AlfonsoUSM/3LFCC_Testboard/testplan/TestPLan_3LFCC.xlsx

Sheet: Tests
 | Test number | Test description | Measurement details | Operating conditions | Equipment/ connection | Reference simulation | more tests?
 | T.01 | Transient output load voltage |  | IL = 0 to Imax/ Fsw = Fmin/ Temp = 25°C/ Nominal switching scheme | Use oscilloscope at filtered output to track and record voltage vs time | TBD | Efficiency
 | T.02 | Transient output load current |  | IL = 0 to Imax/ Fsw = Fmin/ Temp = 25°C/ Nominal switching scheme | Ammeter (sourcemeter?) to record current vs time | TBD | Load regulation?
 | T.03 | Transient input load voltage |  | IL = 0 to Imax/ Fsw = Fmin/ Temp = 25°C/ Nominal switching scheme | Use oscilloscope at filtered output to track and record voltage vs time | TBD | Line regulation?
 | T.04 | Transient input load current |  | IL = 0 to Imax/ Fsw = Fmin/ Temp = 25°C/ Nominal switching scheme | Ammeter (sourcemeter?) to record current vs time | TBD | Load transient response?
 | T.05 | Input/output delay |  | Nominal Imax/ Fsw = Fmin/ Temp = 25°C/ Nominal switching scheme | Oscilloscope at driving signal and output pre-filter voltage | TBD | noice robustness?
 | T.06 | Load voltage range |  | Nominal Imax/ Fsw = Fmin/ Temp = 25°C/ Min. Voltage switching scheme | Use oscilloscope at filtered output to track and record voltage vs time | TBD
 | T.07 | Load current step response |  | Nominal Imax/ Fsw = Fmin/ Temp = 25°C/ Nominal switching scheme | Use oscilloscope at filtered output to track and record voltage vs time | TBD
 | T.08 | Startup transient |  | Nominal Imax/ Fsw = Fmin/ Temp = 25°C/ Nominal switching scheme | Use oscilloscope at filtered output to track and record voltage vs time | TBD
 | T.09 | Switching frequency |  | Nominal Imax/ Fsw = 50MHz?/ Temp = 25°C/ Nominal switching scheme | Use oscilloscope at filtered output to track and record voltage vs time | TBD
 | code | chip (caso) | External Flying Capacitor | Min Switching frequency (Fmin) | op. mode | Max Load Current (Imax)
 | a | standalone | - | 50 MHz | single core output | 150mA
 | b |  |  |  | dual core output | 300mA
 | c |  |  |  | interleaved
 | d | bare die 1 | ? | 10 MHz | single core output | 150mA
 | e |  |  |  | dual core output | 300mA
 | f |  |  |  | interleaved
 | g |  | ? | 1 MHz | single core output | 150mA
 | h |  |  |  | dual core output | 300mA
 | i |  |  |  | interleaved
 | j | bare die 2 | ? | 1 MHz | single core output | 300mA
 | k |  |  |  | dual core output | 600mA
 | l |  |  |  | interleaved
 | Chips (cases) | Nominal Frequency | Max current / core
1 | Standalone Chip (packaged) | 50 MHz | 150 mA
2 | Bare die 1(External capacitor) | 1 MHz / 10 MHz | 150 mA
3 | Bare die 2(Extra bonding for increased current) | 1 MHz / 10 MHz | 300 mA
 | Chip boards
1 | efabless breackout board
2 | custom board for bare die (?)
 | Operation modes
1 | single core
2 | dual core
3 | interleaved
 | Evaluation boards
1 | open loop
2 | closed loop

Sheet: Specs
Spec name | Tests needed | Calculation
Rated power | T.01, T.02 | P_rated = AVG(VOUT)*AVG(IOUT)
Efficiency | T.01, T.02, T.03, T.04 | Efficiency = AVG(VOUT)*AVG(IOUT)/(AVNG(VIN)*AVG(IIN))
Ripple | T.01 | Ripple = MAX(VOUT) - MIN(VOUT)
Driver delay | T.05 | Tdelay = Trise_VOUT - Trise_VIN
Output voltage range | T.06 | Vrange = VOUT_MAX - VOUT_MIN
Startup time | T.08 | Tstartup = T(VOUT = VOUT_SPEC)
