AlfonsoUSM/3LFCC_Testboard/PCB_design/caravel_breakout_QFN.kicad_pcb

## KiCad design PCB_design/caravel_breakout_QFN.kicad_pcb (2023-02-20)

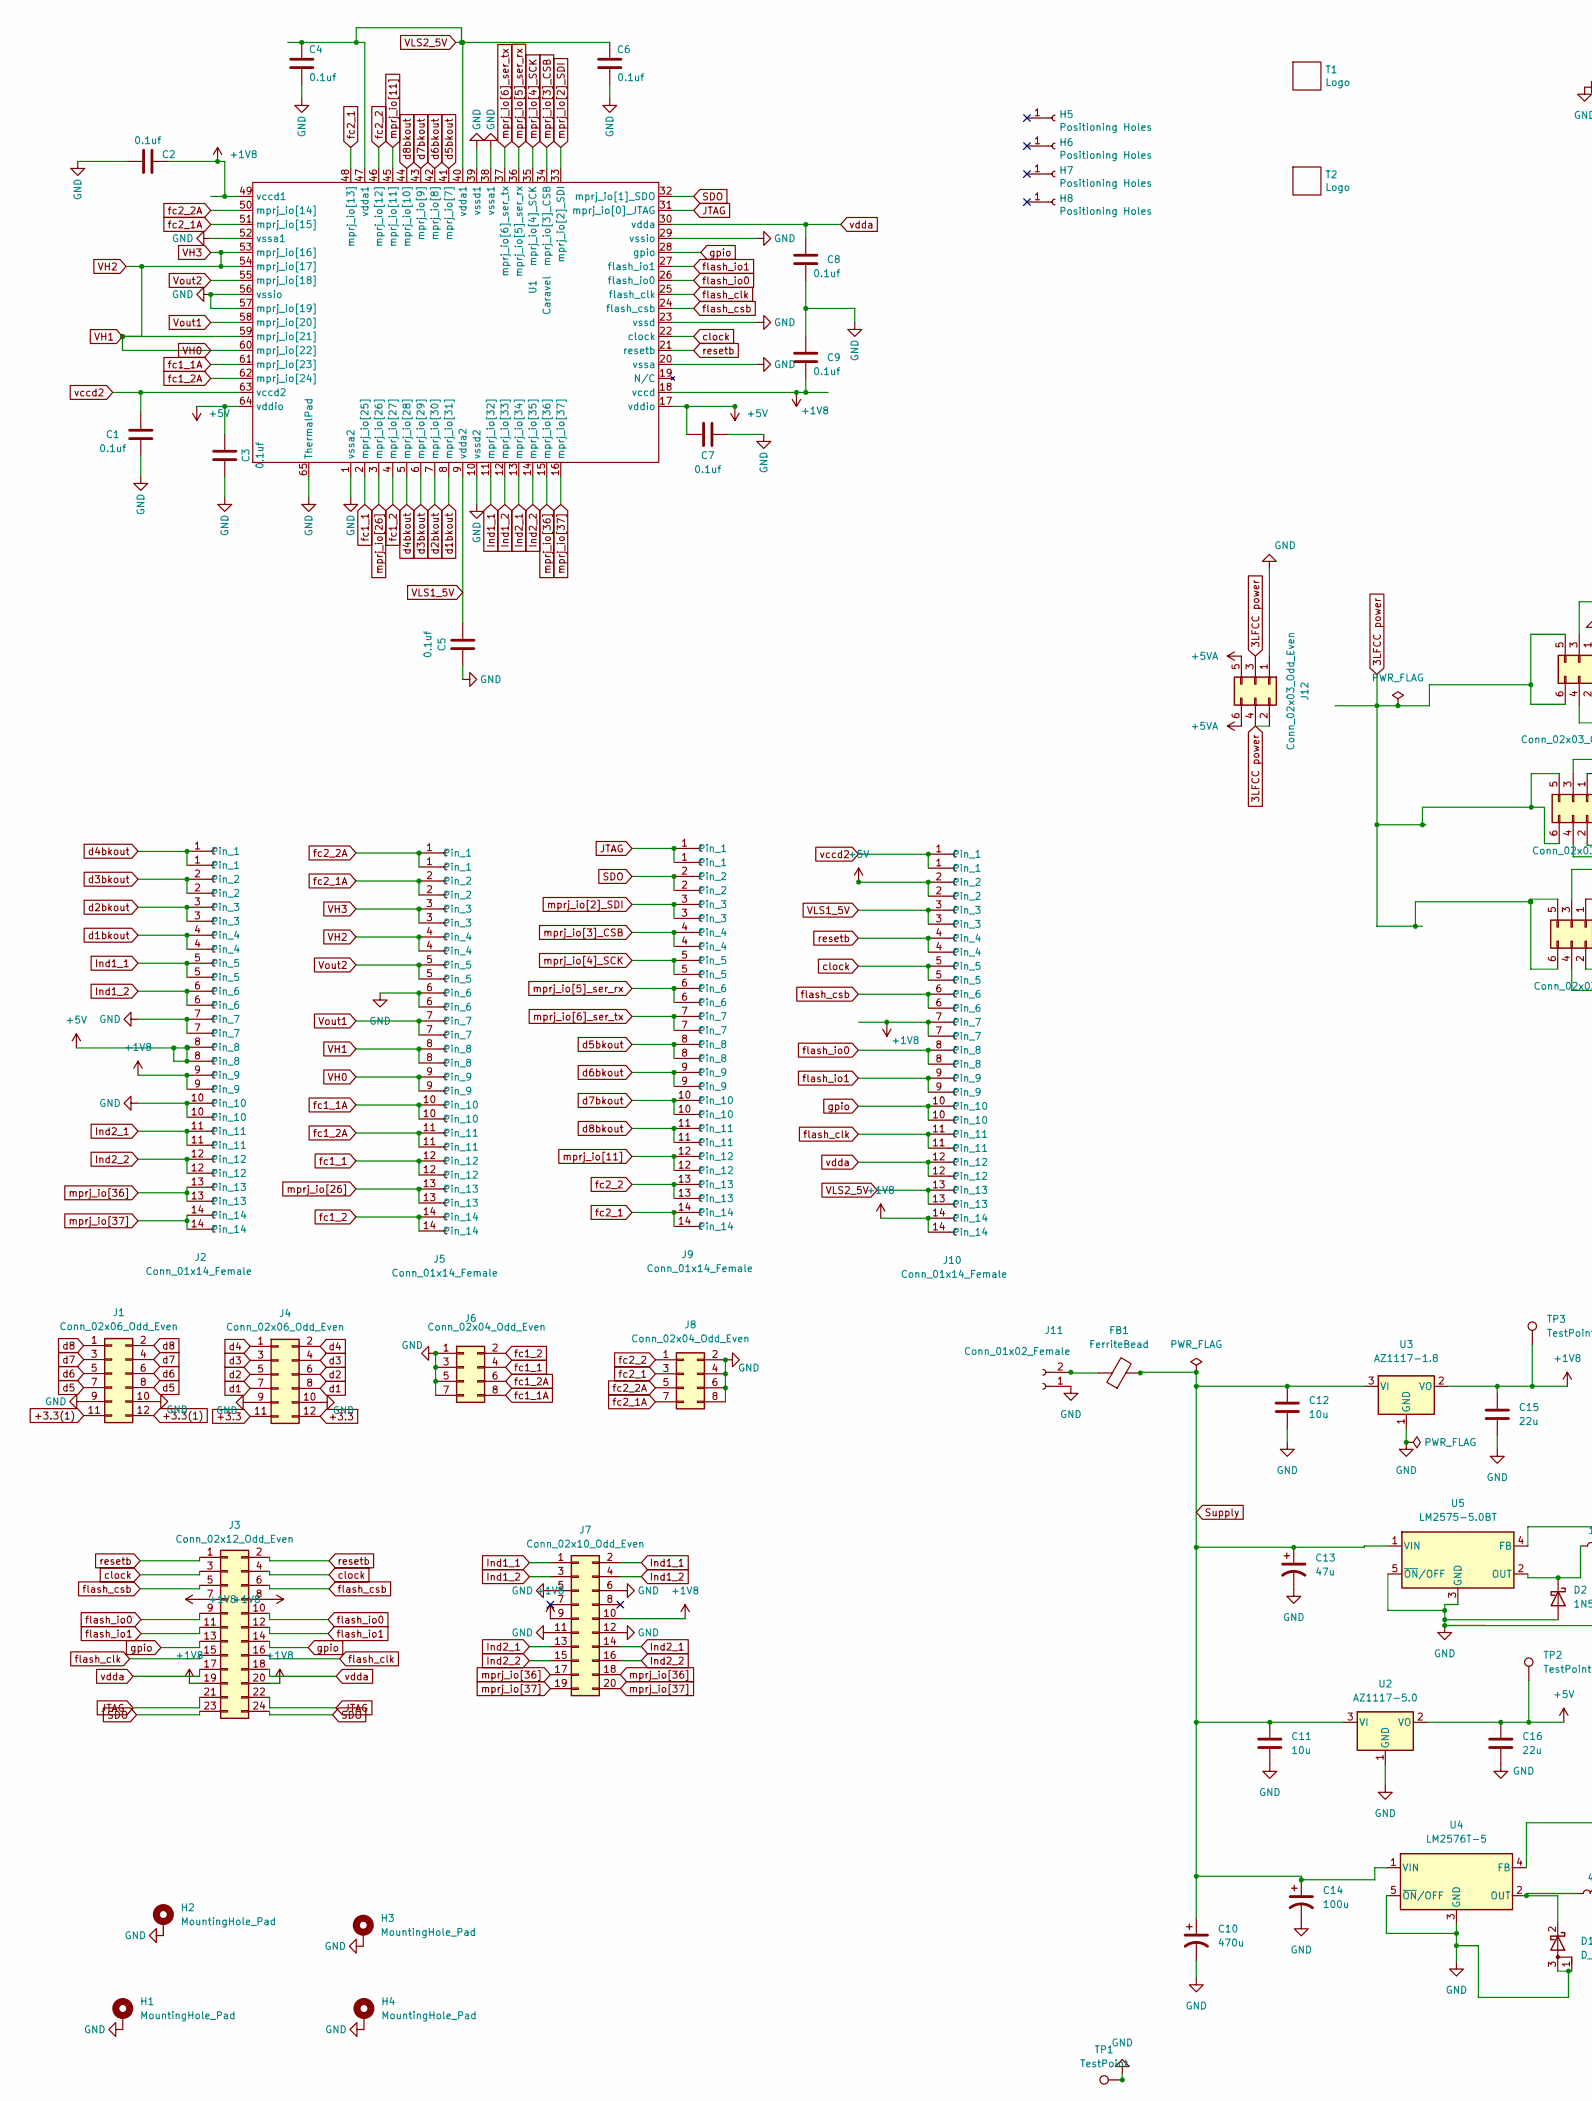
[picture p13: schematic caravel_breakout_QFN.kicad_sch, part in row 1, column 1]

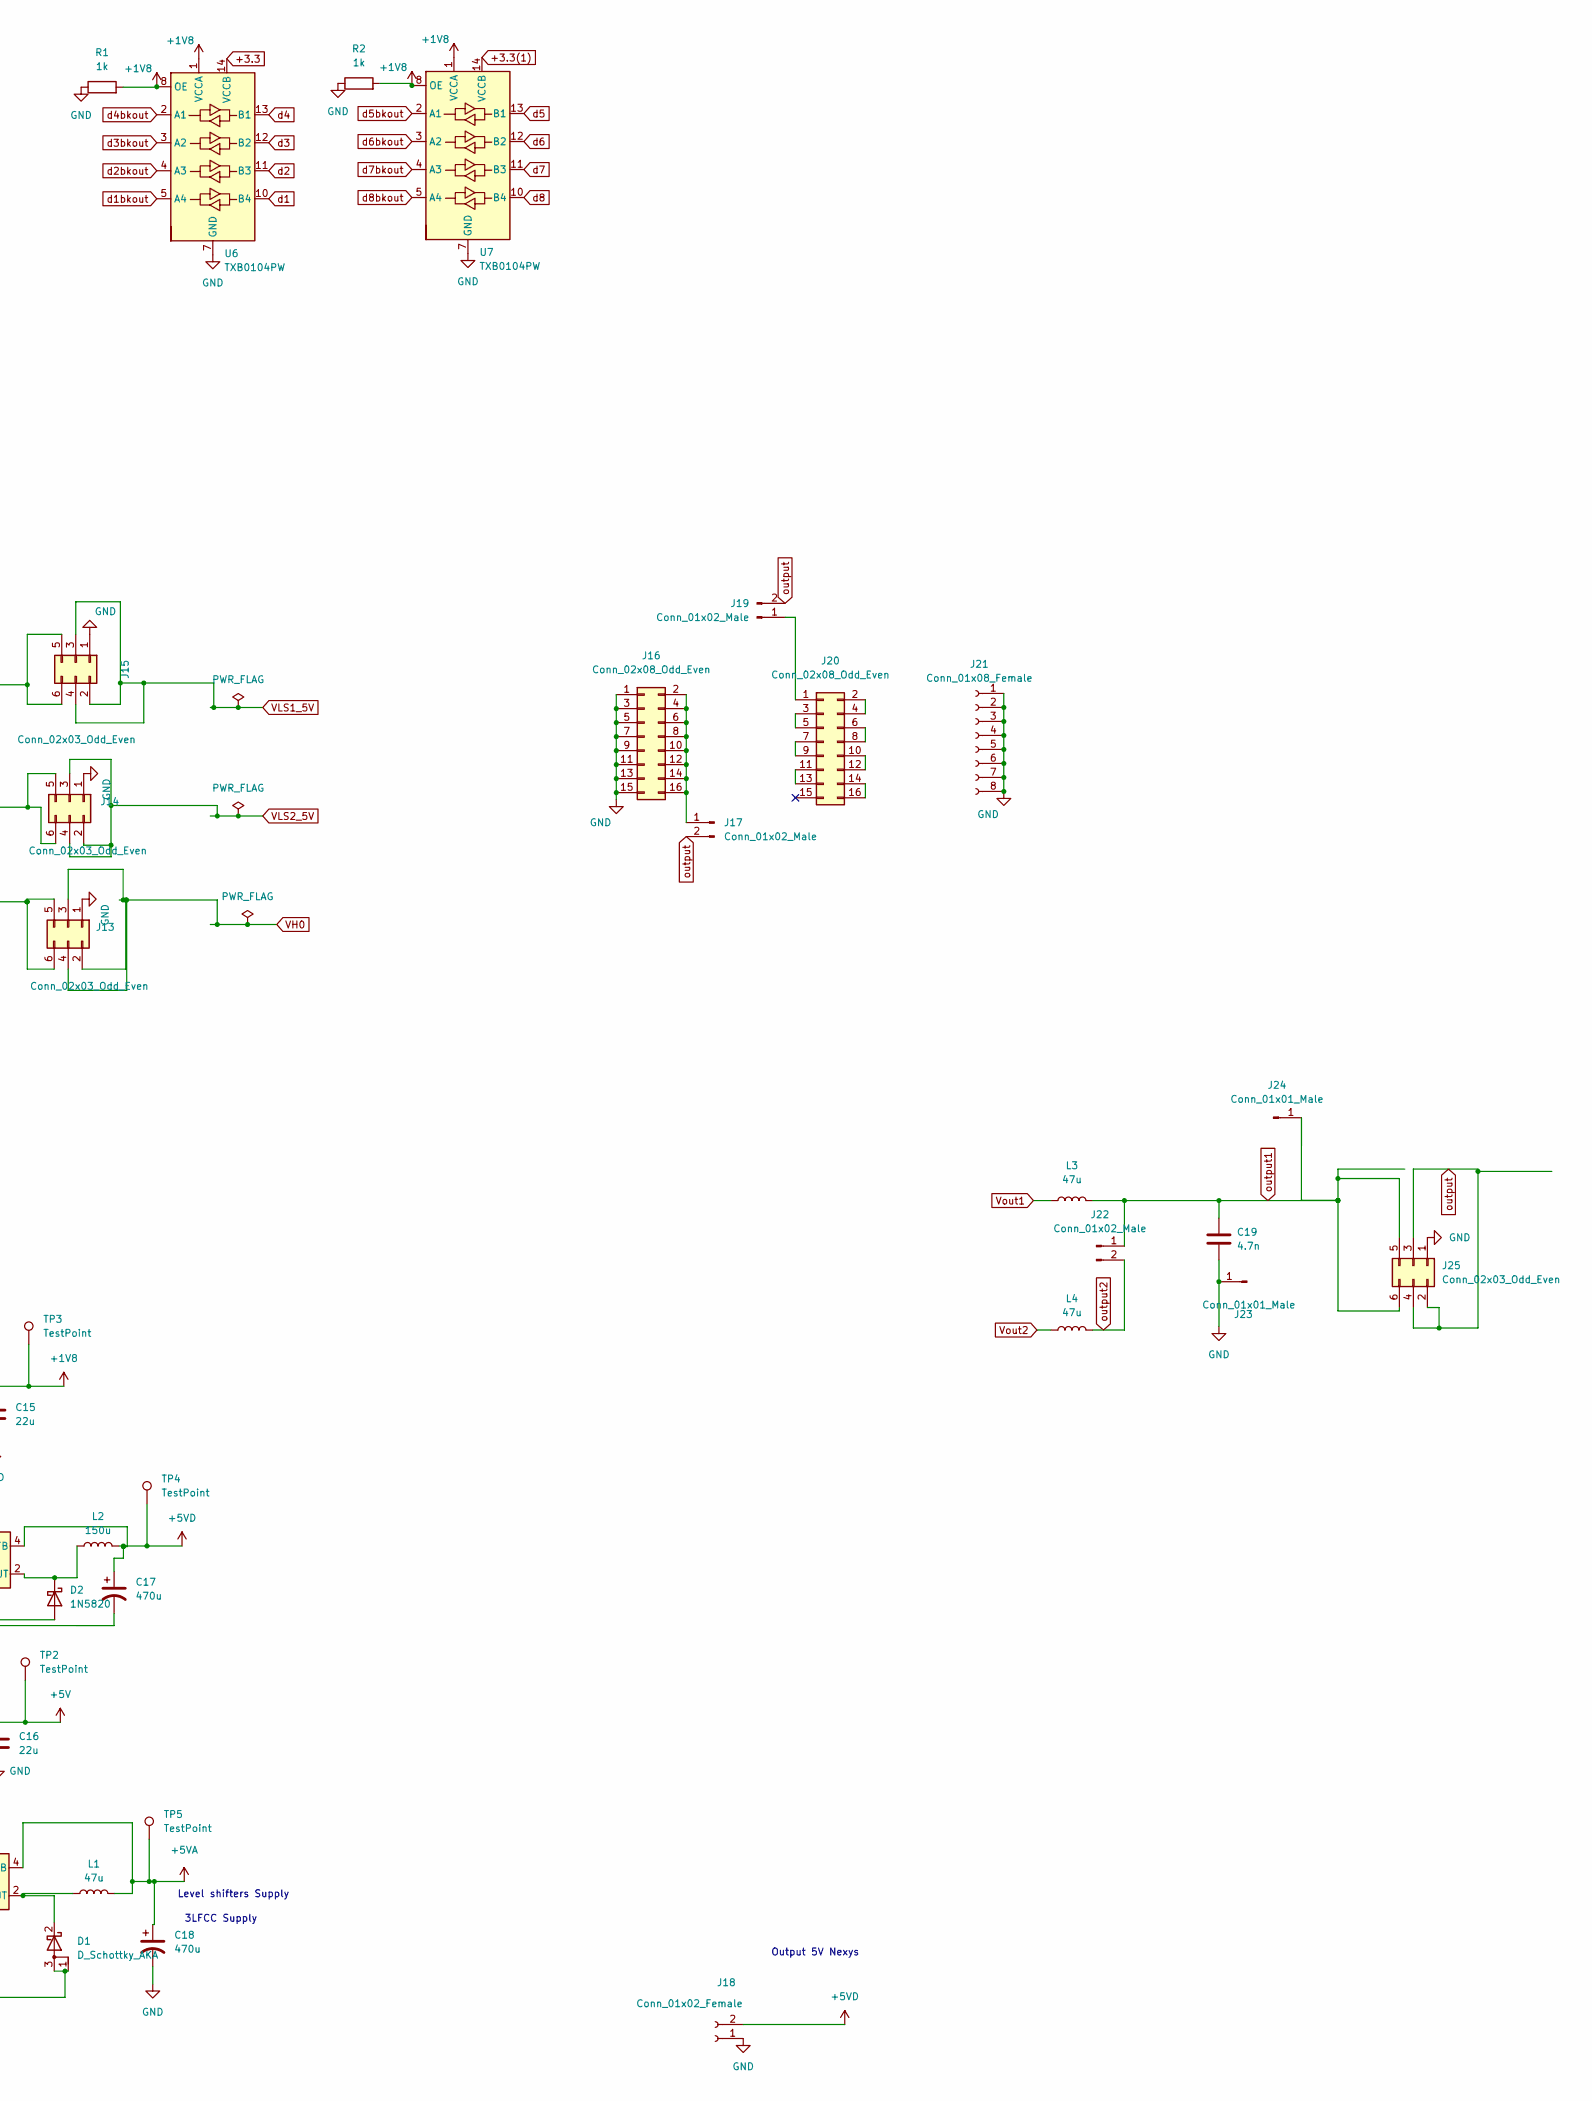
[picture p14: schematic caravel_breakout_QFN.kicad_sch, part in row 1, column 2]

Parts:
C1, C2, C3, C4, C5, C6, C7, C8, C9: 0.1uf; C_0402_1005Metric
C10: 470u; CP_Radial_D10.0mm_P5.00mm
C11, C12: 10u; C_1206_3216Metric
C13: 47u; CP_Radial_D5.0mm_P2.50mm
C14: 100u; C_Radial_D8.0mm_H11.5mm_P3.50mm
C15, C16: 22u; C_1206_3216Metric
C17, C18: 470u; CP_Radial_D10.0mm_P2.50mm
C19: 4.7n; C_1206_3216Metric
D1: D_Schottky_AKA; TO-252-2
D2: 1N5820; D_DO-201AD_P15.24mm_Horizontal
FB1: FerriteBead; L_1206_3216Metric
H1, H2, H3, H4: MountingHole_Pad; MountingHole_3.2mm_M3_Pad
H5, H6, H7, H8: Positioning Holes; MountingHole_2.2mm_M2_ISO7380_Pad
J1, J4: Conn_02x06_Odd_Even; PinSocket_2x06_P2.54mm_Vertical
J2, J5, J9, J10: Conn_01x14_Female; Caravel_Breakout_Connectors_2x14
J3: Conn_02x12_Odd_Even; IDC-Header_2x12_P2.54mm_Horizontal
J6, J8: Conn_02x04_Odd_Even; PinHeader_2x04_P2.54mm_Vertical
J7: Conn_02x10_Odd_Even; IDC-Header_2x10_P2.54mm_Horizontal
J11, J18: Conn_01x02_Female; TerminalBlock_bornier-2_P5.08mm
J12, J13, J14, J15: Conn_02x03_Odd_Even; PinHeader_2x03_P2.54mm_Vertical
J16, J20: Conn_02x08_Odd_Even; PinSocket_2x08_P2.54mm_Vertical
J17, J19, J22: Conn_01x02_Male; PinHeader_1x02_P2.54mm_Vertical
J21: Conn_01x08_Female; PinSocket_1x08_P2.54mm_Vertical
J23, J24: Conn_01x01_Male; PinHeader_1x01_P2.54mm_Vertical
J25: Conn_02x03_Odd_Even; PinHeader_2x03_P2.54mm_Horizontal
L1: 47u; L_Toroid_Vertical_L16.5mm_W11.4mm_P7.62mm_Pulse_KM-2
L2: 150u; L_Toroid_Vertical_L24.6mm_W15.5mm_P11.44mm_Pulse_KM-4
L3, L4: 47u; L_1210_3225Metric
R1, R2: 1k; R_0805_2012Metric
T1: Logo; logo_small
T2: Logo; ef_logo
TP1, TP2, TP3, TP4, TP5: TestPoint; TestPoint_Pad_D1.5mm
U1: Caravel; QFN-64-1EP_9x9mm_P0.5mm_EP7.65x7.65mm
U2: AZ1117-5.0; TO-252-2
U3: AZ1117-1.8; SOT-223-3_TabPin2
U4: LM2576T-5; TO-220-5_Vertical
U5: LM2575-5.0BT; TO-220-5_Vertical
U6, U7: TXB0104PW; TSSOP-14_4.4x5mm_P0.65mm

Connections:
3LFCC power: J12.2, J12.3, J12.4, J13.5, J13.6, J14.5, J14.6, J15.5, J15.6
+1V8: C2.2, C9.2, C15.1, J2.9, J3.7, J3.8, J3.19, J3.20, J7.9, J7.10, J10.7, J10.14, R1.2, R2.2, TP3.1, U1.18 (vccd), U1.49 (vccd1), U3.2 (VO), U6.1 (VCCA), U6.8 (OE), U7.1 (VCCA), U7.8 (OE)
+3.3: J4.11, J4.12, U6.14 (VCCB)
+3.3(1): J1.11, J1.12, U7.14 (VCCB)
+5V: C3.2, C7.2, C16.1, J2.8, J10.2, TP2.1, U1.17 (vddio), U1.64 (vddio), U2.2 (VO)
+5VA: C18.1, J12.5, J12.6, L1.2, TP5.1, U4.4 (FB)
+5VD: C17.1, J18.2, L2.2, TP4.1, U5.4 (FB)
GND: C1.1, C2.1, C3.1, C4.2, C5.1, C6.2, C7.1, C8.2, C9.1, C10.2, C11.2, C12.2, C13.2, C14.2, C15.2, C16.2, C17.2, C18.2, C19.2, D1.1 (A), D1.3 (A), D2.2 (A), H1.1, H2.1, H3.1, H4.1, J1.9, J1.10, J2.7, J2.10, J4.9, J4.10, J5.6, J6.1, J6.3, J6.5, J6.7, J7.5, J7.6, J7.11, J7.12, J8.2, J8.4, J8.6, J8.8, J11.1, J12.1, J13.1, J14.1, J15.1, J16.1, J16.3, J16.5, J16.7, J16.9, J16.11, J16.13, J16.15, J18.1, J21.1, J21.2, J21.3, J21.4, J21.5, J21.6, J21.7, J21.8, J23.1, J25.1, R1.1, R2.1, TP1.1, U1.1 (vssa2), U1.10 (vssd2), U1.20 (vssa), U1.23 (vssd), U1.29 (vssio), U1.38 (vssa1), U1.39 (vssd1), U1.52 (vssa1), U1.56 (vssio), U1.57 (mprj_io[19]), U1.65 (ThermalPad), U2.1 (GND), U3.1 (GND), U4.3 (GND), U4.5 (~ON/OFF), U5.3 (GND), U5.5 (~ON/OFF), U6.7 (GND), U7.7 (GND)
Ind1_1: J2.5, J7.1, J7.2, U1.11 (mprj_io[32])
Ind1_2: J2.6, J7.3, J7.4, U1.12 (mprj_io[33])
Ind2_1: J2.11, J7.13, J7.14, U1.13 (mprj_io[34])
Ind2_2: J2.12, J7.15, J7.16, U1.14 (mprj_io[35])
JTAG: J3.21, J3.22, J9.1, U1.31 (mprj_io[0]_JTAG)
unnamed: D1.2 (K), L1.1, U4.2 (OUT)
unnamed: D2.1 (K), L2.1, U5.2 (OUT)
unnamed: FB1.1, J11.2
unnamed: J16.2, J16.4, J16.6, J16.8, J16.10, J16.12, J16.14, J16.16, J17.1
unnamed: J19.1, J20.1
unnamed: J20.2, J20.4
unnamed: J20.3, J20.5
unnamed: J20.6, J20.8
unnamed: J20.7, J20.9
unnamed: J20.10, J20.12
unnamed: J20.11, J20.13
unnamed: J20.14, J20.16
SDO: J3.23, J3.24, J9.2, U1.32 (mprj_io[1]_SDO)
Supply: C10.1, C11.1, C12.1, C13.1, C14.1, FB1.2, U2.3 (VI), U3.3 (VI), U4.1 (VIN), U5.1 (VIN)
VH0: J5.3, J5.4, J5.8, J5.9, J13.2, J13.3, J13.4, U1.53 (mprj_io[16]), U1.54 (mprj_io[17]), U1.59 (mprj_io[21]), U1.60 (mprj_io[22])
VLS1_5V: C5.2, J10.3, J15.2, J15.3, J15.4, U1.9 (vdda2)
VLS2_5V: C4.1, C6.1, J10.13, J14.2, J14.3, J14.4, U1.40 (vdda1), U1.47 (vdda1)
Vout1: J5.7, L3.1, U1.58 (mprj_io[20])
Vout2: J5.5, L4.1, U1.55 (mprj_io[18])
clock: J3.3, J3.4, J10.5, U1.22 (clock)
d1: J4.7, J4.8, U6.10 (B4)
d1bkout: J2.4, U1.8 (mprj_io[31]), U6.5 (A4)
d2: J4.5, J4.6, U6.11 (B3)
d2bkout: J2.3, U1.7 (mprj_io[30]), U6.4 (A3)
d3: J4.3, J4.4, U6.12 (B2)
d3bkout: J2.2, U1.6 (mprj_io[29]), U6.3 (A2)
d4: J4.1, J4.2, U6.13 (B1)
d4bkout: J2.1, U1.5 (mprj_io[28]), U6.2 (A1)
d5: J1.7, J1.8, U7.13 (B1)
d5bkout: J9.8, U1.41 (mprj_io[7]), U7.2 (A1)
d6: J1.5, J1.6, U7.12 (B2)
d6bkout: J9.9, U1.42 (mprj_io[8]), U7.3 (A2)
d7: J1.3, J1.4, U7.11 (B3)
d7bkout: J9.10, U1.43 (mprj_io[9]), U7.4 (A3)
d8: J1.1, J1.2, U7.10 (B4)
d8bkout: J9.11, U1.44 (mprj_io[10]), U7.5 (A4)
fc1_1: J5.12, J6.4, U1.2 (mprj_io[25])
fc1_1A: J5.10, J6.8, U1.61 (mprj_io[23])
fc1_2: J5.14, J6.2, U1.4 (mprj_io[27])
fc1_2A: J5.11, J6.6, U1.62 (mprj_io[24])
fc2_1: J8.3, J9.14, U1.48 (mprj_io[13])
fc2_1A: J5.2, J8.7, U1.51 (mprj_io[15])
fc2_2: J8.1, J9.13, U1.46 (mprj_io[12])
fc2_2A: J5.1, J8.5, U1.50 (mprj_io[14])
flash_clk: J3.15, J3.16, J10.11, U1.25 (flash_clk)
flash_csb: J3.5, J3.6, J10.6, U1.24 (flash_csb)
flash_io0: J3.9, J3.10, J10.8, U1.26 (flash_io0)
flash_io1: J3.11, J3.12, J10.9, U1.27 (flash_io1)
gpio: J3.13, J3.14, J10.10, U1.28 (gpio)
mprj_io[2]_SDI: J9.3, U1.33 (mprj_io[2]_SDI)
mprj_io[3]_CSB: J9.4, U1.34 (mprj_io[3]_CSB)
mprj_io[4]_SCK: J9.5, U1.35 (mprj_io[4]_SCK)
mprj_io[5]_ser_rx: J9.6, U1.36 (mprj_io[5]_ser_rx)
mprj_io[6]_ser_tx: J9.7, U1.37 (mprj_io[6]_ser_tx)
mprj_io[11]: J9.12, U1.45 (mprj_io[11])
mprj_io[26]: J5.13, U1.3 (mprj_io[26])
mprj_io[36]: J2.13, J7.17, J7.18, U1.15 (mprj_io[36])
mprj_io[37]: J2.14, J7.19, J7.20, U1.16 (mprj_io[37])
output: J17.2, J19.2, J25.2, J25.3, J25.4
output1: C19.1, J22.1, J24.1, J25.5, J25.6, L3.2
output2: J22.2, L4.2
resetb: J3.1, J3.2, J10.4, U1.21 (resetb)
vccd2: C1.2, J10.1, U1.63 (vccd2)
vdda: C8.1, J3.17, J3.18, J10.12, U1.30 (vdda)

Notes on the sheet:
Level shifters Supply
3LFCC Supply
Output 5V Nexys

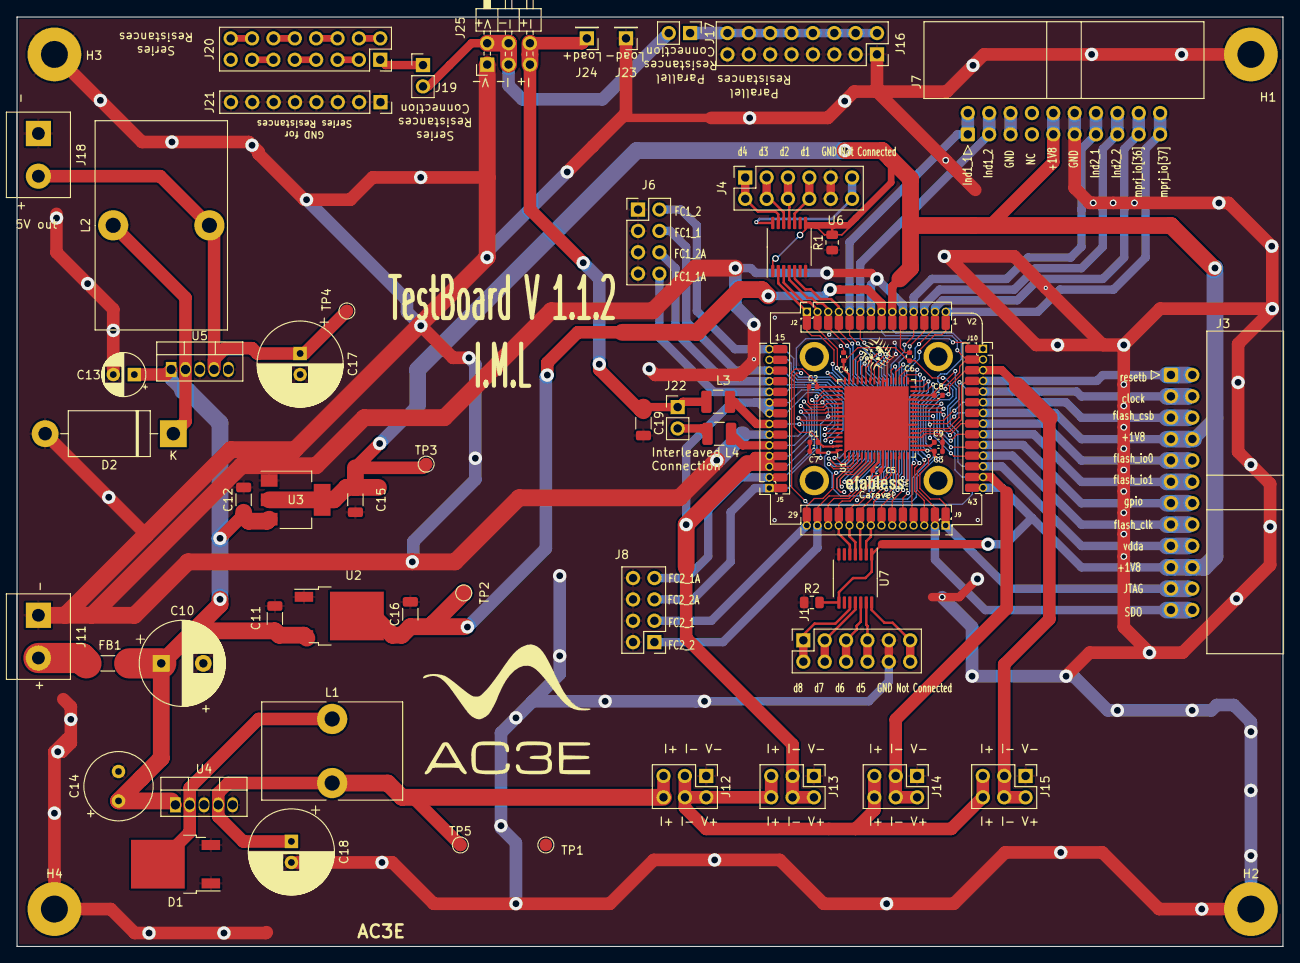
[picture p15: board caravel_breakout_QFN.kicad_pcb from above]

Board: 2 copper layers, 150.5 x 110.5 mm, 76 parts (0 on the bottom side), 77 nets.

Other parts of the board:
AC3E: LOGO; ac3e20footprint
