AlfonsoUSM/3LFCC_Testboard/(commit log)

2023-02-20 Uploaded Test plan
    [TestPLan_3LFCC.xlsx]
2023-02-20 PWM generation
    For Nexys 7 FPGA
2023-02-20 PCB version 1.1.2
    Added level shifters for control pins (3V3 to 1V8).
    [caravel_breakout_QFN.kicad_pcb, caravel_breakout_QFN.kicad_sch]
